kstammits/Shady/sss_back.png

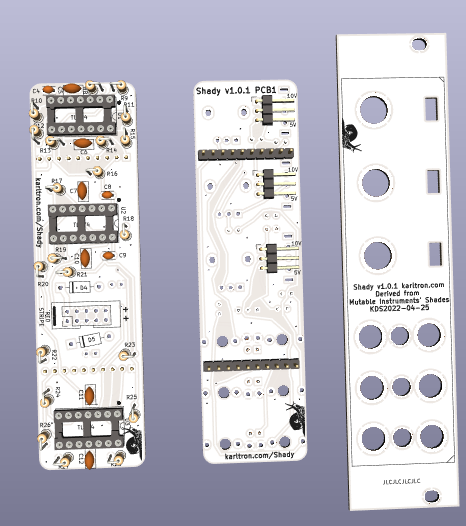
sss_back.png
