kstammits/Shady/sss_front.png

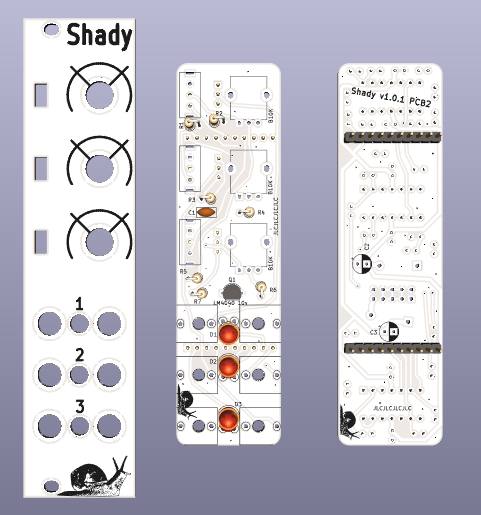
sss_front.png
