kstammits/Shady/Shady.pdf

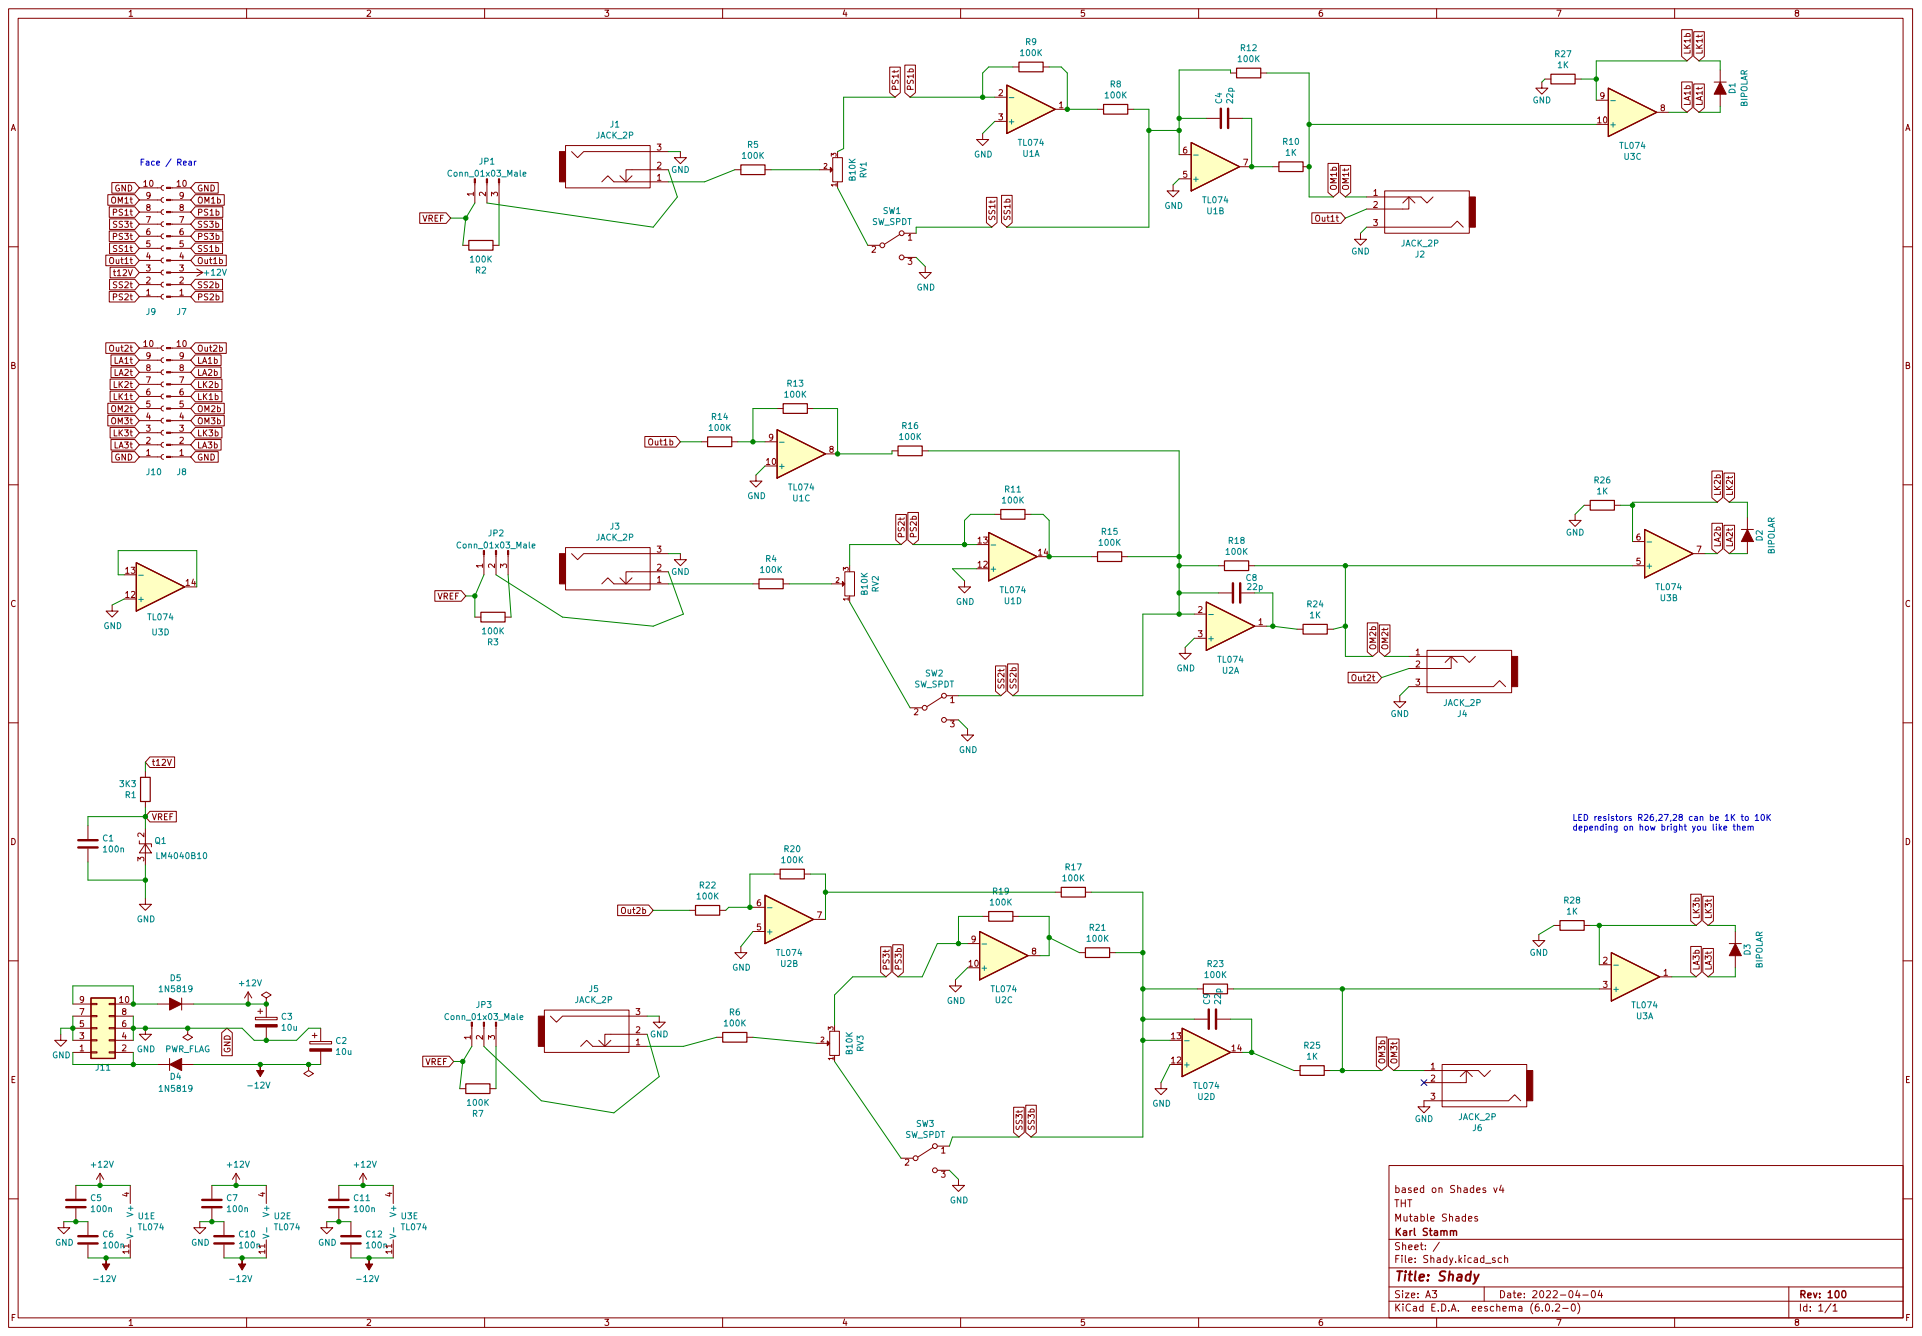
[picture p3: page 1]

depending on how bright you like them

based on Shades v4 GND

File: Shady.kicad_sch Sheet: / Karl Stamm
