kstammits/Shady/(commit log)

2022-04-26 initial commit
    version 1.0.1 of the board complete, might be working but untested
    [Shady.kicad_pcb, Shady.kicad_sch]
2022-04-27 updates for rev101
    [Shady.101.bomguide.xlsx, Shady.101.csv, Shady.kicad_pcb, Shady.kicad_sch]
2022-08-07 v111
    v111 has some triangles on the faceplate
    [Shady.101.bomguide.xlsx, Shady.kicad_pcb]
2022-10-07 update to v121
    switched the switches around so it matches original better
    adjusted logos on front panel
    [Shady.kicad_pcb]
2022-11-19 rearrange steps
    update instructions for easier builds
    [Shady.101.bomguide.xlsx]
